camilamon123/tdse-tf_1-4/firmware/README.md

# Firmware STM32 (Luz-Morse)

Este directorio contiene el proyecto STM32CubeIDE para la NUCLEO-F103RB.

## Código fuente
El proyecto STM32CubeIDE se entrega como ZIP listo para importar:

- `luz-morse-fw-final.zip`

**Importar en CubeIDE:**
1. Descomprimir el ZIP.
2. `File → Import → Existing Projects into Workspace`.
3. Seleccionar la carpeta descomprimida.

> Nota: el proyecto se entrega como ZIP para evitar la limitación de carga masiva de archivos en GitHub. El contenido es únicamente código fuente y archivos de configuración (sin outputs Debug/Release).
