camilamon123/tdse-tf_1-4/Diagrama_de_Gantt_TDSE.pdf

# Planificador del proyecto

Seleccione un periodo para resaltarlo a la derecha. A continuación hay una leyenda que describe el gráfico. | Periodo resaltado: 3

PERIODOS

SEMANAS | 1 2 | 3 | 4 5 6 7 8 9 10 11 12 13 14 15 16 17 18 19 20 21 22 23 24 25 26 27 28 29 30 31 32 33 34 35 36 37 38 39 40 41 42 43 44 45 46 47 48 49 50 51 52 53 54 55 56 57 58 59 60

### 1. Planificación

y diseño

Refinamiento de
requisitos y
arquitectura
1 | 2 | 1 | 2 | 100%

Diseño detallado
del hardware
(esquematico)
3 | 2 | | | 0%

Diseño detallado
del software | 4 | 3 | 35%

Configuración del
entorno de
desarrollo
4 | 3 | | | 10%

### 2. Hardware

Adquisición de
componentes
3 | 1 | | | 85%

Montaje y prueba
inicial en
protoboard
10 | 2 | | | 85%

Diseño y soldadura
del circuito en
placa experimental | 12 | 2 | 50%

### 3. Desarrollo

del Firmware

Configuración de
perifericos base | 9 | 1 | 60%

Módulo 1: Lógica
de sensado y anti-glitches
(adc_light).
9 | 2 | | | 75%

Módulo
2: Máquina de
estados para
decodificación
(morse_decode).
9 | 1 | | | 100%

Módulo
3: Comunicación
Bluetooth
(bt_cmd).
9 | 1 | 60%

Módulo 4: Interfaz
de usuario
(botones, LEDs,
buzzer).
9 | 3 | 0%

Módulo
5: Persistencia en
memoria
E2PROM/Flash
(storage).
9 | 6 | 50%

### 4. Integración y

pruebas

Integración del
firmware
completo en el
hardware final.
9 | 3 | 0%

Pruebas de los
Casos de Uso
(Decodificación y
Calibración).
9 | 4 | 1%

Depuración, ajuste
fino de
temporización y
tolerancias
(WPM).
| 5 | 80%

### 5. Validación y

documentación

Ejecución del Plan
de Medición
(consumo, WCET).
11 | 2 | | | 0%

Redacción del
informe final
(incluye esquemas
y fotos).
12 | 6 | | | 0%

Preparación de la
entrega final. | 12 | 1 | 0%
14 | 5 | 14 | 6 | 0%
14 | 8 | 14 | 2 | 44%
14 | 7 | 14 | 3 | 0%
15 | 4 | 15 | 8 | 12%
15 | 5 | 15 | 3 | 5%
15 | 8 | 15 | 5 | 0%
16 | 28 | 16 | 30 | 50%

TAREAS
PRINCIPALES
Duración del plan | Inicio real | % Completado | Real (fuera del plan) | % Completado (fuera del plan)
Noviembre | Diciembre | Enero | Febrero

PORCENTAJE
COMPLETADO
ACTIVIDAD | INICIO DEL PLAN

DURACIÓN DEL
PLAN

INICIO REAL DURACIÓN REAL
