camilamon123/tdse-tf_1-4/(commit log)

2025-11-17 Rename Captura de pantalla 2025-11-17 161442.png to Diagrama de Bloques
2025-11-17 Rename Diagrama de Bloques to Diagrama de Bloques.png
2025-11-19 Rename Diagrama de Gantt- TDSE.pdf to Diagrama_de_Gantt_TDSE.pdf
2025-11-19 Rename Diagrama de Gantt- TDSE.xlsx to Diagrama_de_Gantt_TDSE.xlsx
    [Diagrama_de_Gantt_TDSE.xlsx]
2025-11-19 README.md
    Propuesta de proyecto para la materia Taller de Sistemas Embebidos
2025-11-25 Clarifica 4.4: Tᵤ, WPM, márgenes y usos
